Gernreich/ghb-chanter/README.md

# Bagpipe chanter

**[← All projects](https://gernreich.github.io/)**

<!-- readme-only -->
**[Read the writeup](https://gernreich.github.io/ghb-chanter/)** ·
**[Turn it in 3D](https://gernreich.github.io/ghb-chanter/)**

<!-- page-only **[Read the README](https://github.com/Gernreich/ghb-chanter)** · **[Turn it in 3D on a page of its own](turn.html)** -->

<!-- page-only <iframe src="turn.html?embed" title="The bagpipe chanter as solid parts you can drag to turn and pull apart: four darker tapering strips with finger-jointed edges and a row of holes along the front, a stack of round collar plates and a narrower tenon at the narrow end, and a round foot at the wide end" style="width:100%;height:560px;border:0"></iframe> -->

A full Great Highland bagpipe chanter in 3 mm plywood. Its conical bore is a tapering
square of four long strips, a hexagon of six or an octagon of eight, finger-jointed and glued, from the
sole up into a collar of stacked plates. The tenon above the collar holds the reed's seat and goes into the
chanter stock. It is the
[standard strip chanter](https://gernreich.github.io/practice-chanters/#the-standard-strip-chanter)
taken to a full chanter: four long strips round a square bore, with a real chanter's
holes.

The real chanter is Jeremy Starcher's
[Dis-Enchanter](https://www.thingiverse.com/thing:2373962) (2017), a 3D-printed chanter
that its designer copied from a 1970s Hardie. Its bore, holes, collar and sole are
measured from its STL, and this chanter keeps every hole where the Dis-Enchanter's is.

Output is millimetre-true — `1 user unit = 1mm` with a physical `width`/`height` — so
it prints and cuts at real size.

**It has not been cut or played yet.** The Dis-Enchanter is a model to follow, not a
proven scale: its designer calls it mostly working, with F and G low on the first print.
The holes here are sized by an acoustic model that cannot reproduce a real chanter's
scale, used only for the difference between this chanter and the Dis-Enchanter.
[Before you cut](#before-you-cut) says what that costs.

<table>
<tr>
<td align="center"><a href="cut-files/ghb-chanter-4-sided-sheet1-cut-files.svg">A sheet of parts: four long tapering strips with finger-jointed edges, one with seven round holes growing larger toward its wide end, one with a single hole near its narrow end, two with one large hole near their wide end; round plates for the collar, getting smaller, and smaller round plates with 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</a></td>
</tr>
<tr>
<td align="center"><sub>four sides: the whole chanter on one 578 × 181 mm sheet</sub></td>
</tr>
<tr>
<td align="center"><a href="cut-files/ghb-chanter-6-sided-sheet1-cut-files.svg">A sheet of parts: six long tapering strips with finger-jointed edges, one with seven slot-shaped holes growing larger toward its wide end, one with a single slot near its narrow end, two with one long slot near their wide end; round collar and tenon plates; twelve curved foot pieces, and three squa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</a></td>
</tr>
<tr>
<td align="center"><sub>six sides: the whole chanter on one 571 × 171 mm sheet</sub></td>
</tr>
<tr>
<td align="center"><a href="cut-files/ghb-chanter-8-sided-sheet1-cut-files.svg">A sheet of parts: eight long, narrow tapering strips with finger-jointed edges, one with seven long slots, one with a single slot near its narrow end, two with one very long slot near their wide end; round collar and tenon plates; sixteen curved foot pieces, and three squares for the foot jig</a></td>
</tr>
<tr>
<td align="center"><sub>eight sides: the whole chanter on one 588 × 179 mm sheet</sub></td>
</tr>
</table>

Built for **[LaserMadeMusic](https://www.youtube.com/@LaserMadeMusic)**.

**[The rest of the build files](https://gernreich.github.io/lasermademusic.html)** — every instrument,
generator and tool, indexed.

**[Download everything as a ZIP](https://github.com/Gernreich/ghb-chanter/archive/refs/heads/main.zip)**

## The chanter

| | |
|---|---|
| Bore | the Dis-Enchanter's cone made square, the same area at every height: 4.57 mm square where the strips meet the collar, 18.76 mm at the sole, against its 5.16 to 21.17 mm round. Each face leans 1.3° |
| Strips | 312 mm long, tapering, finger-jointed, glued. Round each hole its strip owns both corners, so the hole has ply all round |
| Holes | where the Dis-Enchanter's are: seven in the front strip, high A in the back, and a side hole in each side strip near the sole |
| Foot | two layers of four flat strips round the strips' bottom, cut to the Dis-Enchanter's 36.5 mm sole: 6 mm tall, its sole 7.25 mm |
| Collar | the Dis-Enchanter's bead, plate by plate: 34.1, 33.3, 31.5 and 28.2 mm round plates with its 4.8 to 5.1 mm throat, then a 23.1 mm plate the strips' top stands in |
| Tenon | 7 round plates 17 mm across, with the reed's seat tapering 7.0 to 5.2 mm through them, the Dis-Enchanter's taper. Hemp it into the stock |
| Joints | the strips, foot and collar's socket plate glued; the collar's round plates and the tenon press-fit on two 2 mm pins; the seams sealed with shellac |
| Jig | a 46.5 mm square base and two rings with a 36.8 mm hole, pinned into a cup, to glue the foot up in; not part of the chanter |
| Sheet | one 578 × 181 mm sheet of 3 mm ply, 27 parts with the jig |

The table is the four-sided chanter's; [Six sides](#six-sides) and
[Eight sides](#eight-sides) say what changes.

| Hole | Down from the seat's top | This chanter | Its face | The Dis-Enchanter |
|---|---|---|---|---|
| high A, back | 64.3 mm | 5.32 mm | 5.99 mm | 4.80 mm |
| high G | 79.6 mm | 5.35 mm | 6.69 mm | 4.80 mm |
| F | 104.1 mm | 6.81 mm | 7.80 mm | 6.00 mm |
| E | 128.6 mm | 8.15 mm | 8.92 mm | 7.15 mm |
| D | 153.1 mm | 8.72 mm | 10.03 mm | 7.20 mm |
| C | 175.3 mm | 9.61 mm | 11.04 mm | 7.90 mm |
| B | 203.6 mm | 9.86 mm | 12.33 mm | 7.85 mm |
| low A | 234.2 mm | 9.97 mm | 13.72 mm | 7.85 mm |
| side holes, both | 286.2 mm | 13.95 mm | 16.09 mm | 9.60 mm |

**Why the holes are bigger.** The Dis-Enchanter's wall is 2 mm everywhere. A strip is
3 mm, and a hole through a thicker wall sounds flatter, so each hole is opened up until
its note sounds where the Dis-Enchanter's does, in the model. The side holes set low G,
so they are sized for it the same way. High A's hole leaves about 0.34 mm of its face
either side. That is why its strip owns both corners there: the fingers round it are the
strip's own ply.

**Why there is no butt-jointed version.** The practice chanters have one. Here the holes
are too wide for their faces: with butt joints, high A and the side holes would have
under a millimetre of ply beside them before a glue line.

## Six sides

`--sides=6` makes the bore a hexagon of six strips, the same area at every height. The
holes are the same: the model knows the bore only by its area and the wall, so each hole
has the same area as the square chanter's. The back is a face, so the thumb sits on it
as on the square. What changes:

- **The holes are stadiums.** A hexagon's face is 0.55 of the round bore it stands for,
  against the square's 0.89: high A's face is 3.72 mm, where its round hole would be
  5.32 mm. So every hole is a stadium, a slot with round ends, as wide as its face allows
  less 0.35 mm and as long as its area needs. The model takes it as the round hole of
  that area; a slot's sound is not quite a round hole's, so expect more tuning.

| Hole | Down from the seat's top | Stadium, wide × long | Its face |
|---|---|---|---|
| high A, back | 64.3 mm | 3.26 × 7.51 mm | 3.72 mm |
| high G | 79.6 mm | 3.70 × 6.87 mm | 4.15 mm |
| F | 104.1 mm | 4.36 × 9.29 mm | 4.84 mm |
| E | 128.6 mm | 5.02 × 11.47 mm | 5.53 mm |
| D | 153.1 mm | 5.71 × 11.69 mm | 6.22 mm |
| C | 175.3 mm | 6.32 × 12.84 mm | 6.85 mm |
| B | 203.6 mm | 7.13 × 12.24 mm | 7.65 mm |
| low A | 234.2 mm | 8.00 × 11.48 mm | 8.51 mm |
| side holes, both | 286.2 mm | 9.37 × 18.32 mm | 9.98 mm |

- **The corners are 120°.** The fingers are cut square, so, as in RegularBox on the Boxes generator,
  a finger reaches 1.73 mm past its face and the strip beside it stands back 0.87 mm. The
  two strips meet along a line in the middle of the wall, with a small groove inside the
  bore and a notch outside at every finger. The kerf makes that line a light press, and
  the glue seals it. Fill the outside notches with glue too, and shellac the bore.
- **The side holes** are in the back-left and back-right strips, so the bore turns them
  60° toward the back, and they open 9.37 mm wide.
- **The narrowest strip** is 1.90 mm, beside high A, where the back strip owns both its
  corners and the strips beside it give theirs away. Handle the strips with care.
- **The foot** is two layers of six strips; 3.19 mm of it stands past the strips'
  corners, against the square's 0.79 mm.
- **Sheet:** one 571 × 171 mm sheet, 33 parts with the jig.

## Eight sides

`--sides=8` makes the bore an octagon of eight strips. Everything in
[Six sides](#six-sides) holds, more so: the faces are 0.40 of the round bore, so the
slots are narrower and longer.

| Hole | Down from the seat's top | Stadium, wide × long | Its face |
|---|---|---|---|
| high A, back | 64.3 mm | 2.27 × 10.26 mm | 2.73 mm |
| high G | 79.6 mm | 2.60 × 9.22 mm | 3.04 mm |
| F | 104.1 mm | 3.07 × 12.52 mm | 3.55 mm |
| E | 128.6 mm | 3.55 × 15.46 mm | 4.06 mm |
| D | 153.1 mm | 4.05 × 15.60 mm | 4.56 mm |
| C | 175.3 mm | 4.50 × 17.10 mm | 5.03 mm |
| B | 203.6 mm | 5.10 × 16.08 mm | 5.61 mm |
| low A | 234.2 mm | 5.74 × 14.84 mm | 6.24 mm |
| side holes, both | 286.2 mm | 6.72 × 24.19 mm | 7.32 mm |

- **The slots are long.** C's is 17.1 mm along the chanter. Each finger must cover its
  slot's whole length; try the reach before gluing up.
- **The corners are 135°.** A finger reaches 1.24 mm past its face and the strip beside
  it stands back 0.88 mm, meeting it along a line mid-wall as on six sides.
- **Beside high A the fingers are shorter.** The back strip owns both its corners there,
  so a strip on the right owns neither and stands back at both edges. At full reach it
  would be 0.89 mm wide; so from 57.7 to 73.3 mm down the fingers either side of it reach
  1.09 to 1.17 mm, and it is 1.11 mm at its narrowest. A shorter finger meets its neighbour
  the same way, with a deeper notch outside. Handle that strip with care.
- **The side holes** are in the left and right strips, straight out to the sides, as on
  the Dis-Enchanter.
- **The foot** is two layers of eight strips; 3.89 mm of it stands past the strips'
  corners.
- **Sheet:** one 588 × 179 mm sheet, 39 parts with the jig.

## Before you cut

- **The scale is the model's, not a measured one.** The model sounds the Dis-Enchanter's
  own notes 2 to 3 semitones apart from a real chanter's at the top, so it cannot set a
  pitch. It sizes each hole for the difference a 3 mm strip wall makes. If the
  Dis-Enchanter's scale is right, this one should be close; its designer found F and G
  low.
- **The reed decides the pitch.** A Great Highland chanter reed sits in the seat; move it
  in or out to set low A, as on any chanter.
- **The ply must be 3 mm.** Measure it. A strip's thickness is the holes' wall, and the
  holes were sized for 3 mm. Pass `--plate=` with what you measured.
- **Holes open, never close.** Tune a flat note by opening its hole with a file. A sharp
  one needs tape.

## Building it

1. Cut the sheet. Dry-fit the strips first. Each strip's two edges have different
   finger patterns, so it goes in only one way. The strips taper, so the wide ends all go
   to the sole.
2. Glue the strips round a waxed, tapering former, or round a waxed drill bit, to keep
   glue out of the bore. Clamp lightly and wipe off any glue that squeezes out.
3. Press the jig's base and two rings together on two 2 mm pins, and line the cup with
   packing tape or wax so the glue cannot stick to it. Stand the chanter in it on its
   sole. Glue the foot's layers in round the strips one at a time, the circle centring
   each. Each piece runs round one corner of the circle to the inner corner beyond. Each
   layer turns the other way from the one below, so no seam runs through.
4. Press the collar's round plates, widest last, and the tenon together on two 2 mm
   pins. Cut the pins flush with the collar's bottom face.
5. Glue the strips' top 3 mm into the collar's socket plate, and that plate to the
   collar's round plates above it. The pins' ends land on the strips' top, inside the
   socket plate.
6. Seal the bore with shellac on a pipe cleaner, and let it dry. Brush the seams outside.
7. Hemp the tenon into the chanter stock. Push the reed's staple into the seat.

## Turn it in 3D

<!-- readme-only -->
The chanter turns in 3D at the top of the [published page](https://gernreich.github.io/ghb-chanter/),
which GitHub does not run: drag to turn it and pull it apart into its parts, each the
cut file's own outline, four, six or eight sides.

<!-- page-only The 3D view is at [the top of this page](#bagpipe-chanter). It also opens [on a page of its own](turn.html). -->

## Regenerating it

```sh
cargo build --release                                  # once, and after any change
target/release/ghb_chanter --no-write                  # the checks
target/release/ghb_chanter --out=cut-files             # the sheet, four sides
target/release/ghb_chanter --sides=6 --out=cut-files   # the sheet, six sides
target/release/ghb_chanter --sides=8 --out=cut-files   # the sheet, eight sides
target/release/ghb_chanter --plate=2.9 --out=mine      # for ply measured at 2.9mm
target/release/ghb_chanter --kerf=0.18 --out=mine      # for a laser with a 0.18mm kerf
target/release/ghb_chanter --page-to=turn.html         # the 3D view
target/release/ghb_chanter --solidcraft=solidcraft     # the SolidCraft designs
target/release/ghb_chanter --bores                     # its bores, as bore-tmm reads them
```

The generator is Rust since 2026-11-07, and Python before that: the move changed no byte
of any cut file or page. It builds on `practice_chanters.rs`, `strip_chanter.rs` and
`chanter_model.rs` from [practice-chanters](https://github.com/Gernreich/practice-chanters),
and through them on [square-flute](https://github.com/Gernreich/square-flute),
[four-hole-ocarinas](https://github.com/Gernreich/four-hole-ocarinas) and
[swept-curve](https://github.com/Gernreich/swept-curve); on the cone kernel in
[bore-tmm](https://github.com/Gernreich/bore-tmm)'s `src/models.rs`; and on
[lasermade-tools](https://github.com/Gernreich/lasermade-tools) for the 3D view. Check
them all out side by side.

Writing anything, it first checks:

- every note sounds where the Dis-Enchanter's does, in the model;
- every hole is where the Dis-Enchanter's is, and fits its face at its area;
- every hole keeps ply all round it, and every corner is one strip's all the way;
- the strips make the Dis-Enchanter's cone, and none is too narrow anywhere;
- the collar is its bead, the foot its sole, and the seat its taper;
- the foot clears the side holes, and the jig holds it on its circle;
- every pin keeps ply round it;
- the sheet fits the bed, and no two parts on it come closer than the gap.

## The model

The bore is an exact cone, closed at its apex: a conical bore sounds as the whole cone,
and the missing tip stands in for the reed. The holes are Keefe's tone holes on it, as in
the practice chanters'
[chanter_model.rs](https://github.com/Gernreich/practice-chanters/blob/main/chanter_model.rs),
which supplies the fingering and the scale. The Dis-Enchanter's notes in the model are
the targets, and each hole of this chanter is sized until its note matches, to within a
cent.

## Files

| | |
|---|---|
| `cut-files/ghb-chanter-4-sided-sheet1-cut-files.svg` | the four-sided chanter: strips, foot, collar, tenon, and the foot jig |
| `cut-files/ghb-chanter-6-sided-sheet1-cut-files.svg` | the six-sided chanter, the same parts |
| `cut-files/ghb-chanter-8-sided-sheet1-cut-files.svg` | the eight-sided chanter, the same parts |
| `previews/ghb-chanter-4-sided-sheet1-cut-files.svg` · `previews/ghb-chanter-6-sided-sheet1-cut-files.svg` · `previews/ghb-chanter-8-sided-sheet1-cut-files.svg` | display renderings of the sheets — **not** cut files |
| `turn.html` | the 3D view, on a page of its own |
| `ghb_solidcraft.rs` · `solidcraft/` | the chanter as a parametric SolidCraft design, and the designs it writes |
| `ghb_chanter.rs` | the generator: the Dis-Enchanter's measures, the cone model, the tapering strips, its checks |
| `Cargo.toml` · `Cargo.lock` | the crate and its pinned build |
| `README.md` · `index.html` | this writeup and its published page; the markdown is the source |
| `.repro` | the command that draws each generated file |
| `.doc-audit-links` | the one link the link check may find refusing scripts: Thingiverse answers them all 403 |

The Dis-Enchanter is by Jeremy Starcher (jstarcher on Thingiverse) and is licensed
[CC BY-NC-SA](https://creativecommons.org/licenses/by-nc-sa/4.0/). This chanter is made
from its measures, so it is released under the same licence:
[CC BY-NC-SA 4.0](LICENSE).

## SolidCraft designs

`ghb_chanter --solidcraft=solidcraft` also writes the chanter as a parametric SolidCraft
design for each number of sides: the rules it follows are expressions there, so
changing one number rebuilds the rest. Open a `.sc` from `solidcraft/` in SolidCraft.
The parameters are under the **SOLID** tab, **MODIFY** panel, **Change Parameters**;
the Browser lists the parts and the timeline every step. Each `.solidcraft.json` beside
it is the script it was built from (`solidcraft-cli run FILE --save NAME.sc`). The `.sc`
holds the design without SolidCraft's build cache, which it rebuilds on opening, so it
is the same file every time.

- `solidcraft/ghb-chanter-4-sides.sc` · `solidcraft/ghb-chanter-4-sides.solidcraft.json`
- `solidcraft/ghb-chanter-6-sides.sc` · `solidcraft/ghb-chanter-6-sides.solidcraft.json`
- `solidcraft/ghb-chanter-8-sides.sc` · `solidcraft/ghb-chanter-8-sides.solidcraft.json`

| Parameter | Default | What it is |
|---|---|---|
| `ply` | 3 mm | plate thickness: the strips, every plate, the joints' depth, as `--plate=` |
| `cone_a` · `cone_b` | 3.463 mm · 0.05132 | the reference's cone, across at the seat's top and per mm down; the strips' faces are its polygon of the same area |
| `seat_a` · `seat_b` · `seat_deep` · `throat` | 7.155 mm · −0.0991 · 22 · 25.25 mm | the reed's tapered seat, and where the cone starts |
| `sole` · `tenon_d` · `foot_d` | 345 · 17 · 36.5 mm | the bore's end, the tenon, the round foot |
| `z_1` … `z_8` · `z_v` | the reference's | each hole down from the seat's top, hA first, and the side holes |
| `d_1` … `d_8` · `d_v` | the solver's | each round hole's diameter for the reference's note, as a cubic in the ply |
| `web_face` | 0.35 mm | a round hole this much narrower than its face at least; past it a stadium of the same area |
| `finger` · `min_finger` · `min_web` | 10 · 4 · 1.5 mm | a joint cell, about; no finger shorter; the guard round each hole, where its strip owns both corners |
| `pin` · `pin_interf` | 2 · 0.1 mm | the tenon's and collar's pins, and their press-fit |

The tuning follows the ply but nothing else: the holes' sizes are what the model's
solver found, and no expression redoes it. The solver was run at every 0.05 mm of ply
from 2.5 to 3.5 mm (at 3.6 it finds low G flat), and each size is a cubic in the ply
through the 3 mm value, within 0.002 mm of the solver everywhere. They are parameters
so a chanter tuned by hand can be written back into its design; change the cone and the
notes move until the generator is run again. The joints do follow, as the generator works them out: `ncell` and
`cell`, each hole's width and length (`w3_` and `l3_`, round until the face is too
narrow, worked out three times over as the generator does), each guard (`g0_` and
`g1_`), and the generator's tidying of short scraps between two guards (`jl_` … `par_`).
`reach` and `k_back` are a finger's reach past its face's edge and how far the strip
beside it stands back, from the angle between the faces; where a strip owns neither
corner and its face is too narrow, the design caps the reach as the generator does.
Where the tidy or a cap changes with the ply (on the 8-sided chanter, at eleven plies
between 2.64 and 3.41 mm; on four and six sides never), each band is on only over the
plies the generator makes it, and parked elsewhere: a cut a metre down the strip, a
join a 0.3 mm square inside solid wood 30 mm up from the strip's end. Between 3.183 and
3.192 mm of ply the 8-sided design does not build: the generator's tidy there leaves a
step about a hundredth of a millimetre long, and SolidCraft's cut of the side holes
fails on it.
`k_lean` is how far down the axis a length along a leaning face reaches: the generator
draws each strip's length, joints and holes along its face, so the design lays them
there too, and a strip cut `ls` long stops 0.08 to 0.10 mm short of the sole, as the
cut one does.
The plates are drawn one by one, each its seat's or bead's diameter at its height, so
the tenon's 7, the collar's 4 and the foot's 2 layers stay those counts.

**Checked** part by part against the generator's own 3D view: all 24, 30 and 36 parts
matched to within 0.09 mm (2026-11-08), the sag of the earlier STEP files' straight runs
round a curve. Built by the generator at 2.9 mm ply and given the same numbers, six and
eight sides matched exactly and four sides but for 2.2 mm³ of the side holes' straight
runs. Since 2026-11-09 the strips run along their faces as the cut sheet draws them,
where the 3D view lays them down the axis, so they now stand up to 0.1 mm off it: six
and eight sides match within 0.105 mm, and four sides but for the side holes and two
finger holes' edges, which sit 0.04 to 0.06 mm higher than the view's.
Changed to another ply and laid flat by `sc-flatten`, then set beside the generator's
sheets at that ply (`sc-replay`), the designs agree (cuts within 0.05 mm) at every ply
tried where the generator passes its own checks: 2.5, 2.65, 2.7, 2.9, 3.03 and 3.1 mm
on all three, 2.6 on four and six sides, and on eight 2.645, 2.68, 2.73, 2.8, 3.05 and
3.2 mm too, beside its switch points (2026-11-11).
Laid flat again by `sc-flatten` (lasermade-tools) and set beside the committed cut
sheets, the designs agree to within 0.049 mm on four sides (27 parts), 0.040 mm on six
(33) and 0.041 mm on eight (39) (2026-11-09); the most is the foot pieces' arcs, round
in the design and a polygon on the sheet.

## STEP files

`step/` holds each SolidCraft design, built by SolidCraft, as a STEP file to open or
import in a CAD program such as Fusion or FreeCAD: one solid body per part, in
millimetres, assembled, with no parameters. Holes and plates are true circles.
`.repro` checks them:

```
target/release/ghb_chanter --solidcraft=solidcraft
solidcraft-cli run solidcraft/ghb-chanter-4-sides.solidcraft.json --out step/ghb-chanter-4-sides.step
```

The files:

- `step/ghb-chanter-4-sides.step`
- `step/ghb-chanter-6-sides.step`
- `step/ghb-chanter-8-sides.step`

## Credits

Made by Michael Gernreich with [Claude](https://www.anthropic.com/claude) (Anthropic), working in Claude Code, which co-wrote the code and the documentation. Commits Claude made carry a `Co-Authored-By: Claude` line.
