Gernreich/ghb-chanter/step/ghb-chanter-4-sides.step

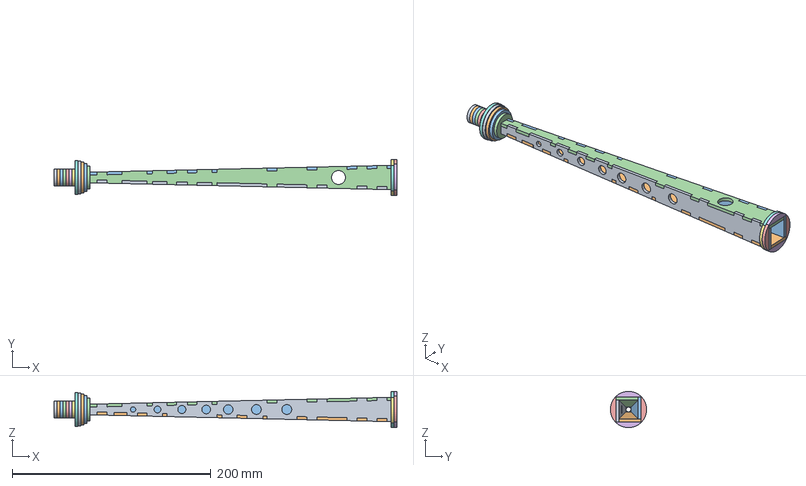
[picture p1: CAD file, 2026-11-09]
step/ghb-chanter-4-sides.step
345.0 x 36.5 x 36.5 mm
