Gernreich/ghb-chanter/step/ghb-chanter-8-sides.step

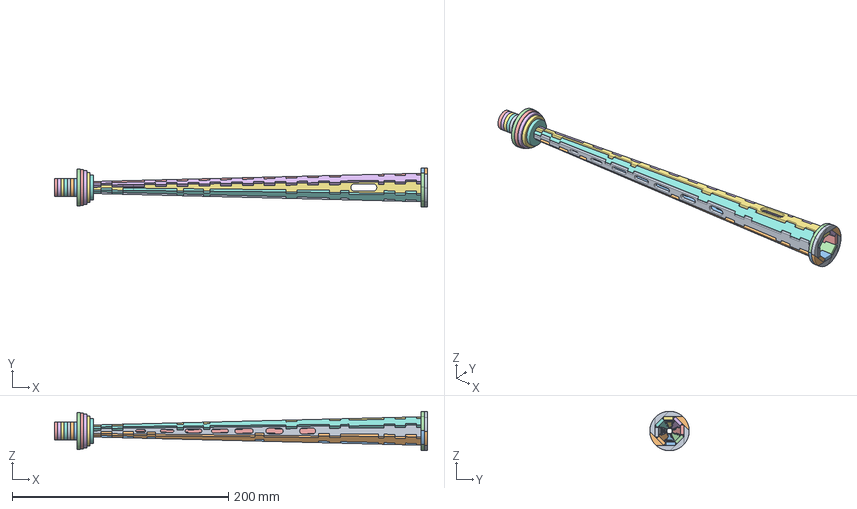
[picture p2: CAD file, 2026-11-09]
step/ghb-chanter-8-sides.step
345.0 x 36.5 x 36.5 mm
