Gernreich/ghb-chanter/step/ghb-chanter-6-sides.step

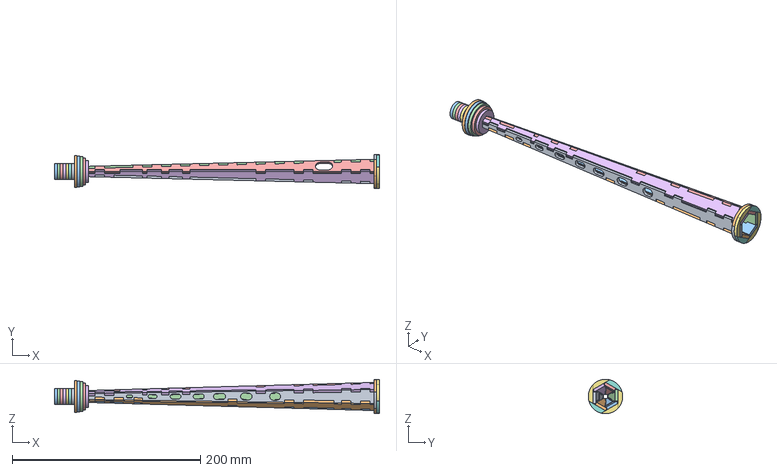
[picture p3: CAD file, 2026-11-09]
step/ghb-chanter-6-sides.step
345.0 x 36.5 x 36.5 mm
