Gernreich/ghb-chanter/(commit log)

2026-10-20 Bagpipe chanter: the strip chanter taken to a full Great Highland chanter
    A tapering square bore of four finger-jointed strips, the Dis-Enchanter's
    cone (Jeremy Starcher, 2017, Thingiverse 2373962) made square at the same
    area. Its holes where the Dis-Enchanter's are, each sized in a cone model
    for the 3mm strip wall; its bead as the collar, its sole as the foot, its
    seat in a stacked tenon. CC BY-NC-SA 4.0, as the reference is.
2026-10-20 Six sides: --sides=6, a hexagonal bore of six strips with stadium holes
    The holes keep the square chanter's areas; each is a stadium as wide as its
    face allows. 120-degree finger joints as in RegularBox: a finger reaches
    1.73mm past its face, the strip beside it stands back 0.87mm. Eight sides
    is taken but fails its checks: the faces are too narrow.
2026-10-20 Eight sides: an octagonal bore with slot holes
    Where a hole's strip owns both corners, the strip that owns neither gets
    shorter fingers either side of it (1.09-1.17mm, against 1.24), so it stays
    1.11mm wide beside high A instead of 0.89. Four and six are unchanged.
2026-10-21 Review: pin the collar before gluing it on; channel, hub and ZIP links; 3D on the published page
2026-10-22 Link back to all projects at the top of the README and the page
    The rest of the build files now points at lasermademusic.html, where the
    instruments moved when the root page became a directory.
2026-10-23 3D view: fitted to its frame, and framed bare at the top of the page
2026-11-05 Loss radius is the bore's radius, not half of it
    Matches the other chanter models. The reference notes move 2.7-6.0 cents
    flat in the model; the solved holes change by at most 0.017mm (vents
    0.053mm), below the kerf.
2026-11-07 Call lasermade-tools' Rust programs, not its Python scripts
    The tools became Rust on 2026-11-07: target/release/<name> in lasermade-tools
    (cargo build --release there) replaces python3 <name>.py, in commands,
    manifests and prose. Pages rebuilt; no generated file changes otherwise.
2026-11-07 3D page through lasermade-tools' turn3d program; turn3d.py is gone
    The page is byte for byte the same.
2026-11-07 ghb_chanter.rs: the generator is Rust, every cut file and page byte for byte the same; --bores for bore-tmm
2026-11-08 Cargo.lock: four-hole-ocarinas now builds on square-flute
2026-11-08 Cargo.lock: bore-tmm now depends on lasermade-tools and roxmltree
2026-11-08 STEP files of the 3D view, for a CAD program
    One file per design in step/, one solid body per part, written from the
    3D page by lasermade-tools step-export and checked by .repro. Every file
    opens in SolidCraft with every body closed and no warnings.
    [ghb-chanter-4-sides.step, ghb-chanter-6-sides.step, ghb-chanter-8-sides.step]
2026-11-08 Parametric SolidCraft designs for 4, 6 and 8 sides; STEPs built by SolidCraft
    ghb_solidcraft.rs writes each as a SolidCraft script (ghb_chanter
    --solidcraft=DIR): each leaning strip sketched along its face with its
    fingers, cells, guards and holes and intersected with its wall's slab; the
    cone, ply and holes are parameters and the joints follow them, including
    the generator's tidying between close guards and its capped reaches.
    Checked part by part: 24, 30 and 36 parts within 0.09 mm, and at 2.9 mm ply
    against the generator's own build.
    [ghb-chanter-4-sides.step, ghb-chanter-6-sides.step, ghb-chanter-8-sides.step]
2026-11-09 SolidCraft design: strips laid along their leaning faces, as the sheets cut them
    k_lean puts the generator's lengths, joints and hole ends along each face;
    down the axis a strip came out 0.15 mm longer than its cut outline. The
    sc-flatten round trip now agrees on 4, 6 and 8 sides (0.049, 0.040, 0.041 mm).
    [ghb-chanter-4-sides.step, ghb-chanter-6-sides.step, ghb-chanter-8-sides.step]
2026-11-11 SolidCraft designs: the joints and holes follow the ply
    The generator's tidy and capped reaches are worked out at every ply
    from 2.5 to 3.5 mm, and each band is on only over the plies where the
    generator makes it, parked elsewhere. Hole diameters are cubics in the
    ply. Replayed at other plies, the designs agree with the generator's
    sheets wherever its own checks pass (2.5 to 3.2 mm).
